ResRipper/OpenThereminV4/Electronics/OpenThereminV45_BOM.ods

Reference | Value | Footprint | Qty | LCSC | PN | Vendor | Note
C1,C2,C3,C7,C8,C9,C10 | 150p | Capacitor_SMD:C_0603_1608Metric | 7 | C107038 | CC0603JRNPO9BN151 | YAGEO | C0G/N0P
C5,C12 | 470p | Capacitor_SMD:C_0603_1608Metric | 2 | C106211 | CC0603JRNPO9BN471 | YAGEO | C0G/N0P
C6,C13,C20,C21,C23,C24,C25,C26,C27,C28,C30,C32,C33,C35 | 100n | Capacitor_SMD:C_0603_1608Metric | 14 | C282519 | TCC0603X7R104K500CT | CCTC
C11 | 10pF | Capacitor_SMD:C_0603_1608Metric | 1 | C376764 | TCC0603COG100J500CT | CCTC | C0G/N0P
C14 | 47p | Capacitor_SMD:C_0603_1608Metric | 1 | C94904 | 0603CG470J500NT | FH | C0G/N0P
C15,C16,C34 | 22p | Capacitor_SMD:C_0603_1608Metric | 3 | C105620 | CC0603JRNPO9BN220 | YAGEO | C0G/N0P
C17,C18 | 30p | Capacitor_SMD:C_0603_1608Metric | 2 | C107047 | CC0603JRNPO9BN330 | YAGEO | C0G/N0P
C22,C38 | 10n | Capacitor_SMD:C_0603_1608Metric | 2 | C376807 | TCC0603X7R103M500CT | CCTC
C29,C36,C37 | 10u | Capacitor_SMD:C_0603_1608Metric | 3 | C1691 | CL10A106MQ8NNNC | Samsung
D1,D2 | BB914 | TO_SOT_Packages_SMD:SOT-23 | 2 | C3272485 | BB914E6327HTSA1 | Infineon
D3 | LTST-C235KGKRKT | LED_SMD:LED_LiteOn_LTST-C235KGKRKT | 1 | C125110 | LTST-C235KGKRKT | LITEON
J3 | Conn_02x04_Odd_Even | Connector_PinHeader_1.27mm:PinHeader_2x04_P1.27mm_Vertical_SMD | 1 | C19268845 | XDZ127-2-04-S-1.0-G1 | XUNDA
J4,J5 | PJ-320B | Library:XKB_PJ-320B | 2 | C2884998 | PJ-320B-SMT | XKB
J6 | USB_C_Receptacle_USB2.0_16P | Connector_USB:USB_C_Receptacle_GCT_USB4105-xx-A_16P_TopMnt_Horizontal | 1 | C2988369 | GT-USB-7010AB | G-Switch
L1,L2 | 1mH | Inductor_SMD:L_1812_4532Metric | 2 | C394145 | FHW1812IF102KST | FH
P1,P2,P3,P4 | 10k | Library:ALPS_RK09K1130A6S | 4 | C209770 | RK09K1130A6S | ALPS
R1,R5,R11,R13 | 4.7M | Resistor_SMD:R_0603_1608Metric | 4 | C322165 | RS-03L4704FT | FH | 1%
R2,R6,R9,R10,R20 | 2.2k | Resistor_SMD:R_0603_1608Metric | 5 | C294652 | RS-03K2201FT | FH | 1%
R3,R4,R7,R8,R15,R16 | 100k | Resistor_SMD:R_0603_1608Metric | 6 | C3152121 | SC0603F1003F2BNRH | Sunway | 1%
R12,R14,R18,R19 | 470 | Resistor_SMD:R_0603_1608Metric | 4 | C116694 | RS-03K4700FT | FH | 1%
R17 | 10k | Resistor_SMD:R_0603_1608Metric | 1 | C3152123 | SC0603F1002F2BNRH | Sunway
R21,R22 | 5.1k | Resistor_SMD:R_0603_1608Metric | 2 | C3152148 | SC0603F5101F2BNRH | Sunway | 1%
U1 | TTP223 | Package_TO_SOT_SMD:SOT-23-6 | 1 | C5345654 | HK2301 | Hichon
U2,U3 | 74HC4060D | Package_SO:SOIC-16_3.9x9.9mm_P1.27mm | 2 | C5649 | 74HC4060D,653 | Nexperia
U4 | 74HC74 | Package_SO:SOIC-14_3.9x8.7mm_P1.27mm | 1 | C27597 | 74HC74D,653 | Nexperia
U5 | HEF4069 | Package_SO:SOIC-14_3.9x8.7mm_P1.27mm | 1 | C6739 | HEF4069UBT,653 | Nexperia
U6 | MCP4921-E/SN | Package_SO:SOIC-8_3.9x4.9mm_P1.27mm | 1 | C43499 | MCP4921-E/SN | Microchip
U7,U12 | MCP4922-E/SL | Package_SO:SOIC-14_3.9x8.7mm_P1.27mm | 2 | C39851 | MCP4922-E/SL | Microchip
U8 | MCP6002T-I/SN | Package_SO:SOIC-8_3.9x4.9mm_P1.27mm | 1 | C20538868 | MCP6002T-I/SN(MS) | MSKSEMI
U9 | ATmega328P-AU | Package_QFP:TQFP-32_7x7mm_P0.8mm | 1 | C14877 | ATmega328P-AU | Microchip
U10 | CH340C | Package_SO:SOIC-16_3.9x9.9mm_P1.27mm | 1 | C84681 | CH340C | WCH
U11 | LP2985-3.3 | Package_TO_SOT_SMD:SOT-23-5 | 1 | C95414 | LP2985-33DBVR | Ti
X1 | 16MHz | Crystal:Crystal_SMD_HC49-SD | 1 | C7473031 | M49SMD16M15PF15PPM | SST | 15~18pF
X2 | 7.3728MHz | Crystal:Crystal_SMD_HC49-SD | 1 | C19173022 | RC07372602 | TROQ | 20pF
J1,J7 | Pitch / Volume | Connector_Coaxial:SMA_Amphenol_132134-11_Vertical | 2 | C5723187 | SMA-KE-347A-H13.5-P | Xunpu
