ResRipper/OpenThereminV4/Electronics/OpenThereminV45.kicad_pcb

## KiCad design Electronics/OpenThereminV45.kicad_pcb (2024-10-14)

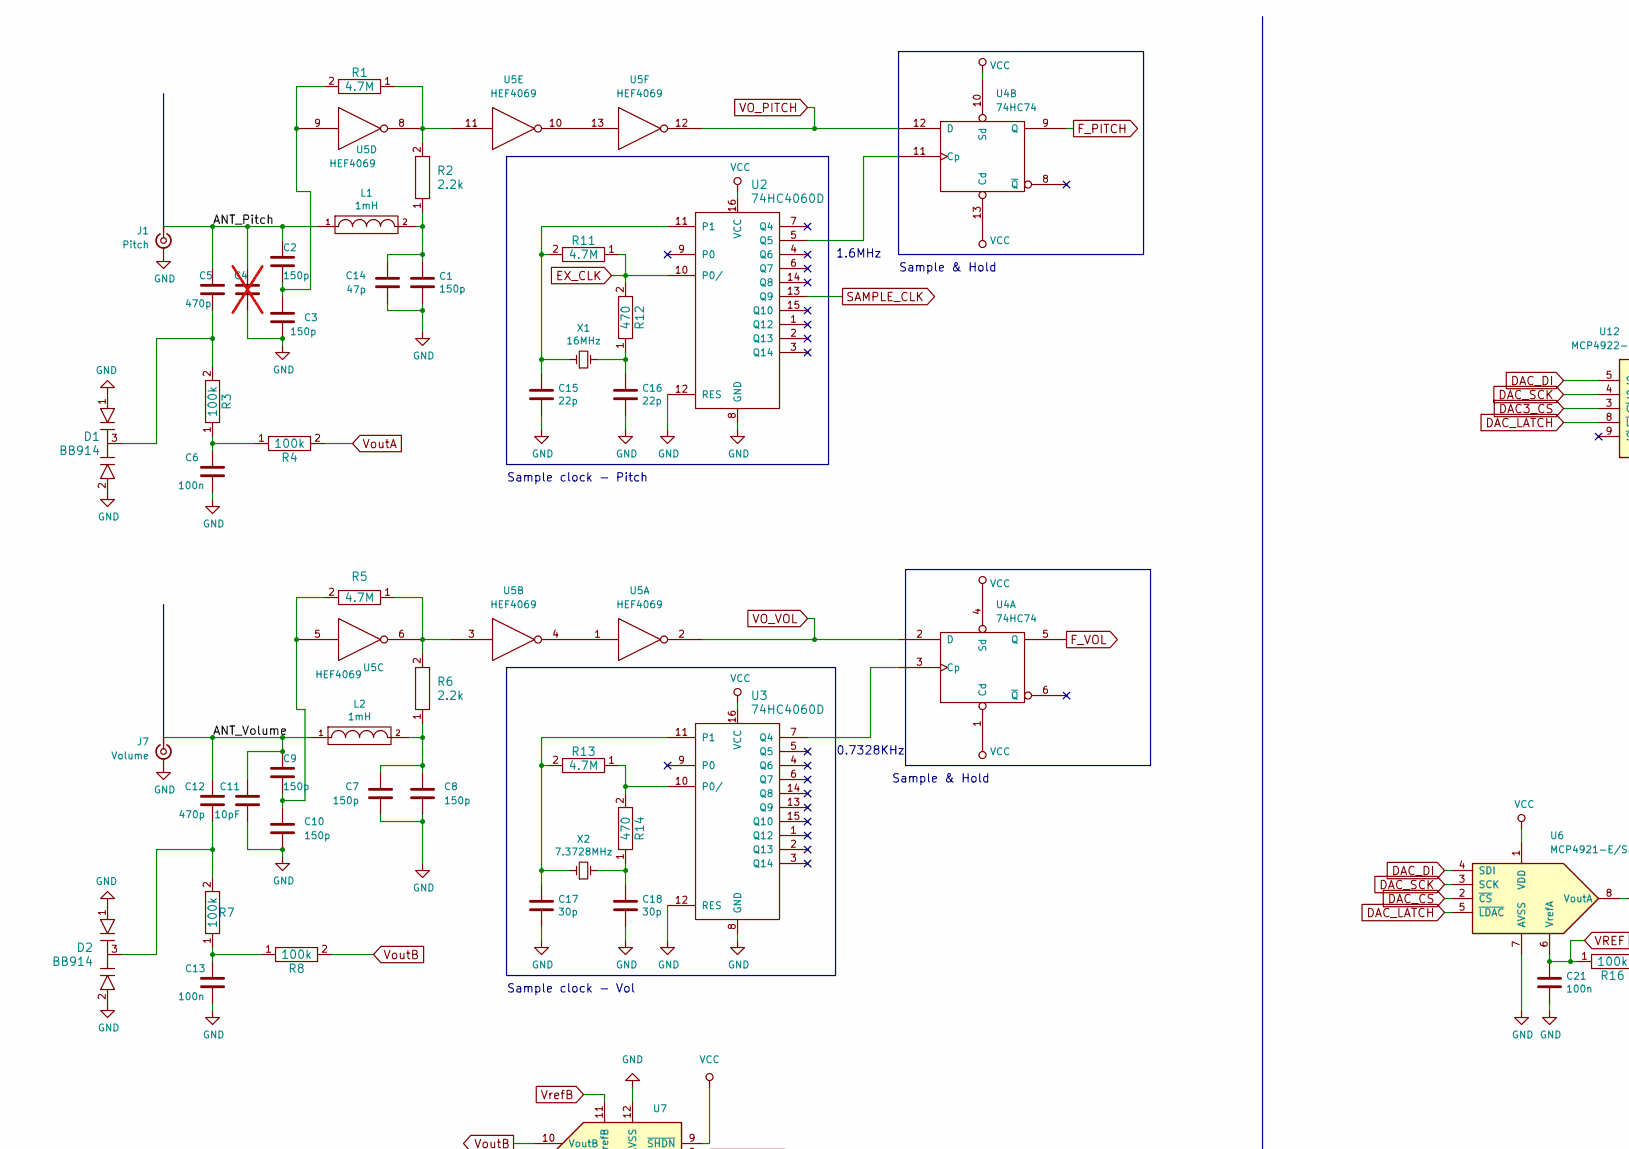
[picture p1: schematic OpenThereminV45.kicad_sch, Open.Theremin V4.5, part in row 1, column 1]

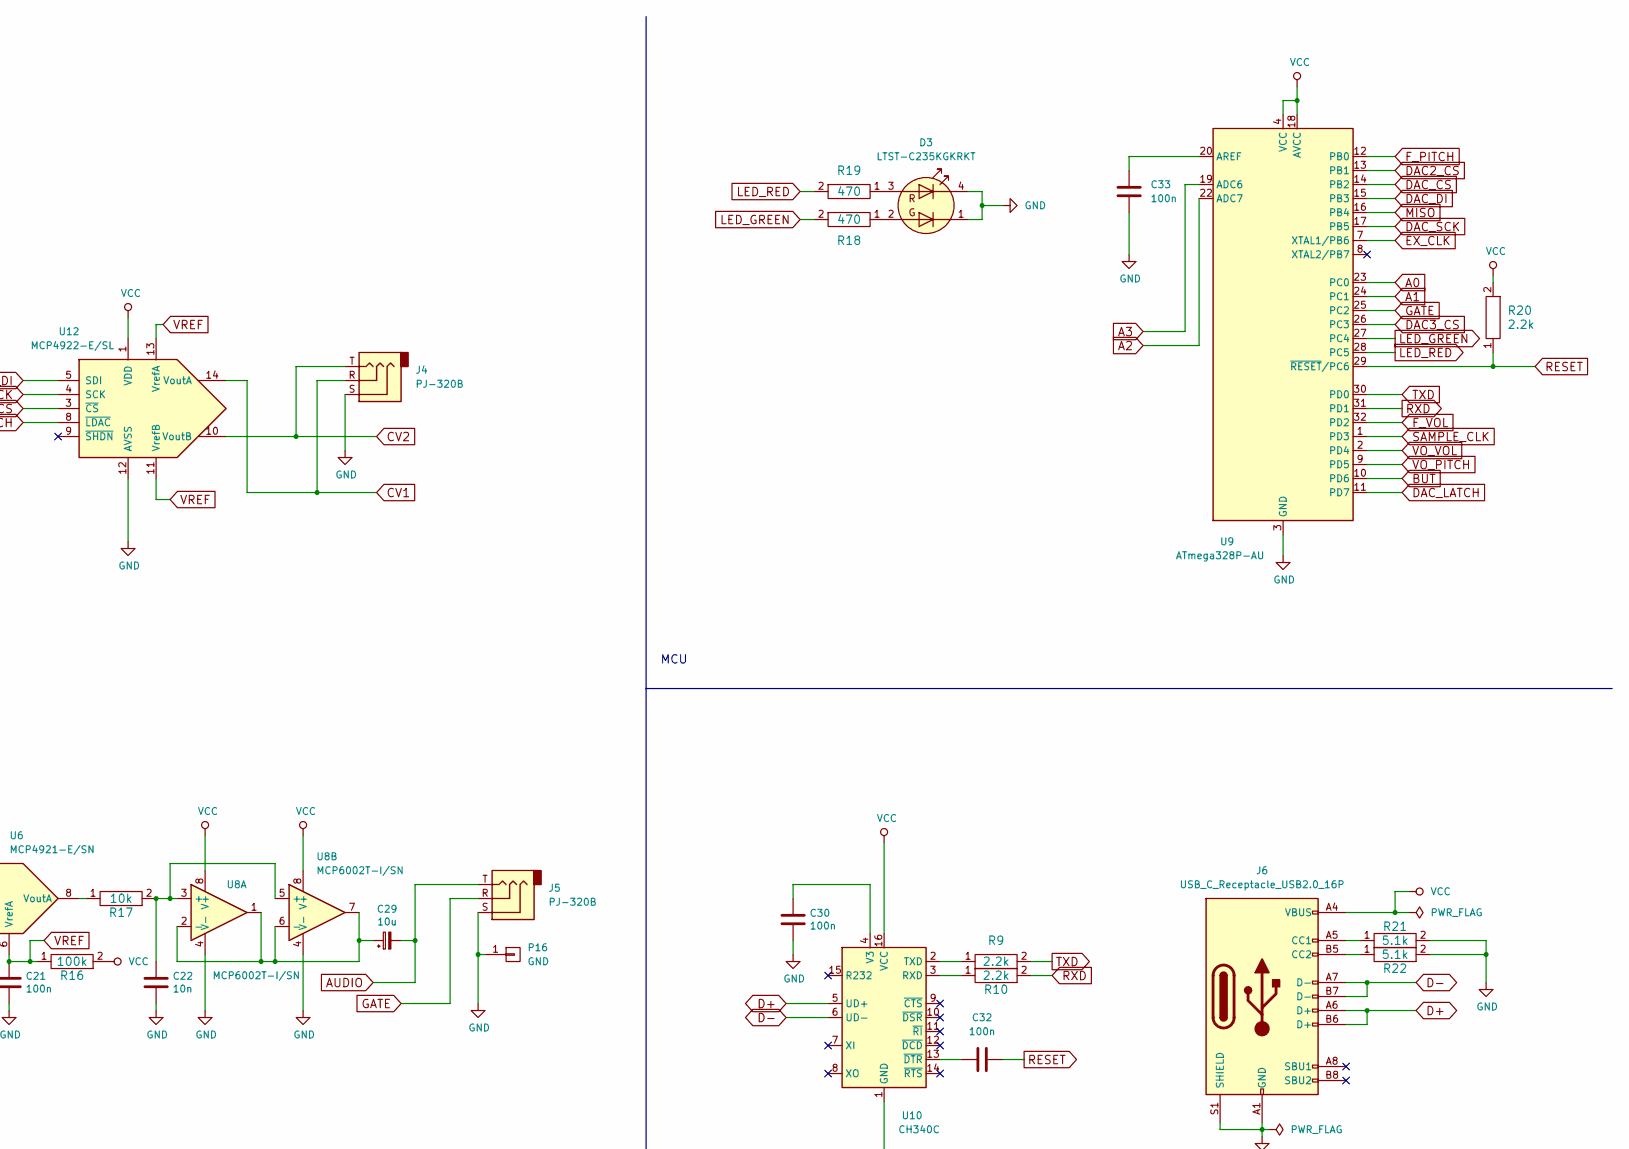
[picture p2: schematic OpenThereminV45.kicad_sch, Open.Theremin V4.5, part in row 1, column 2]

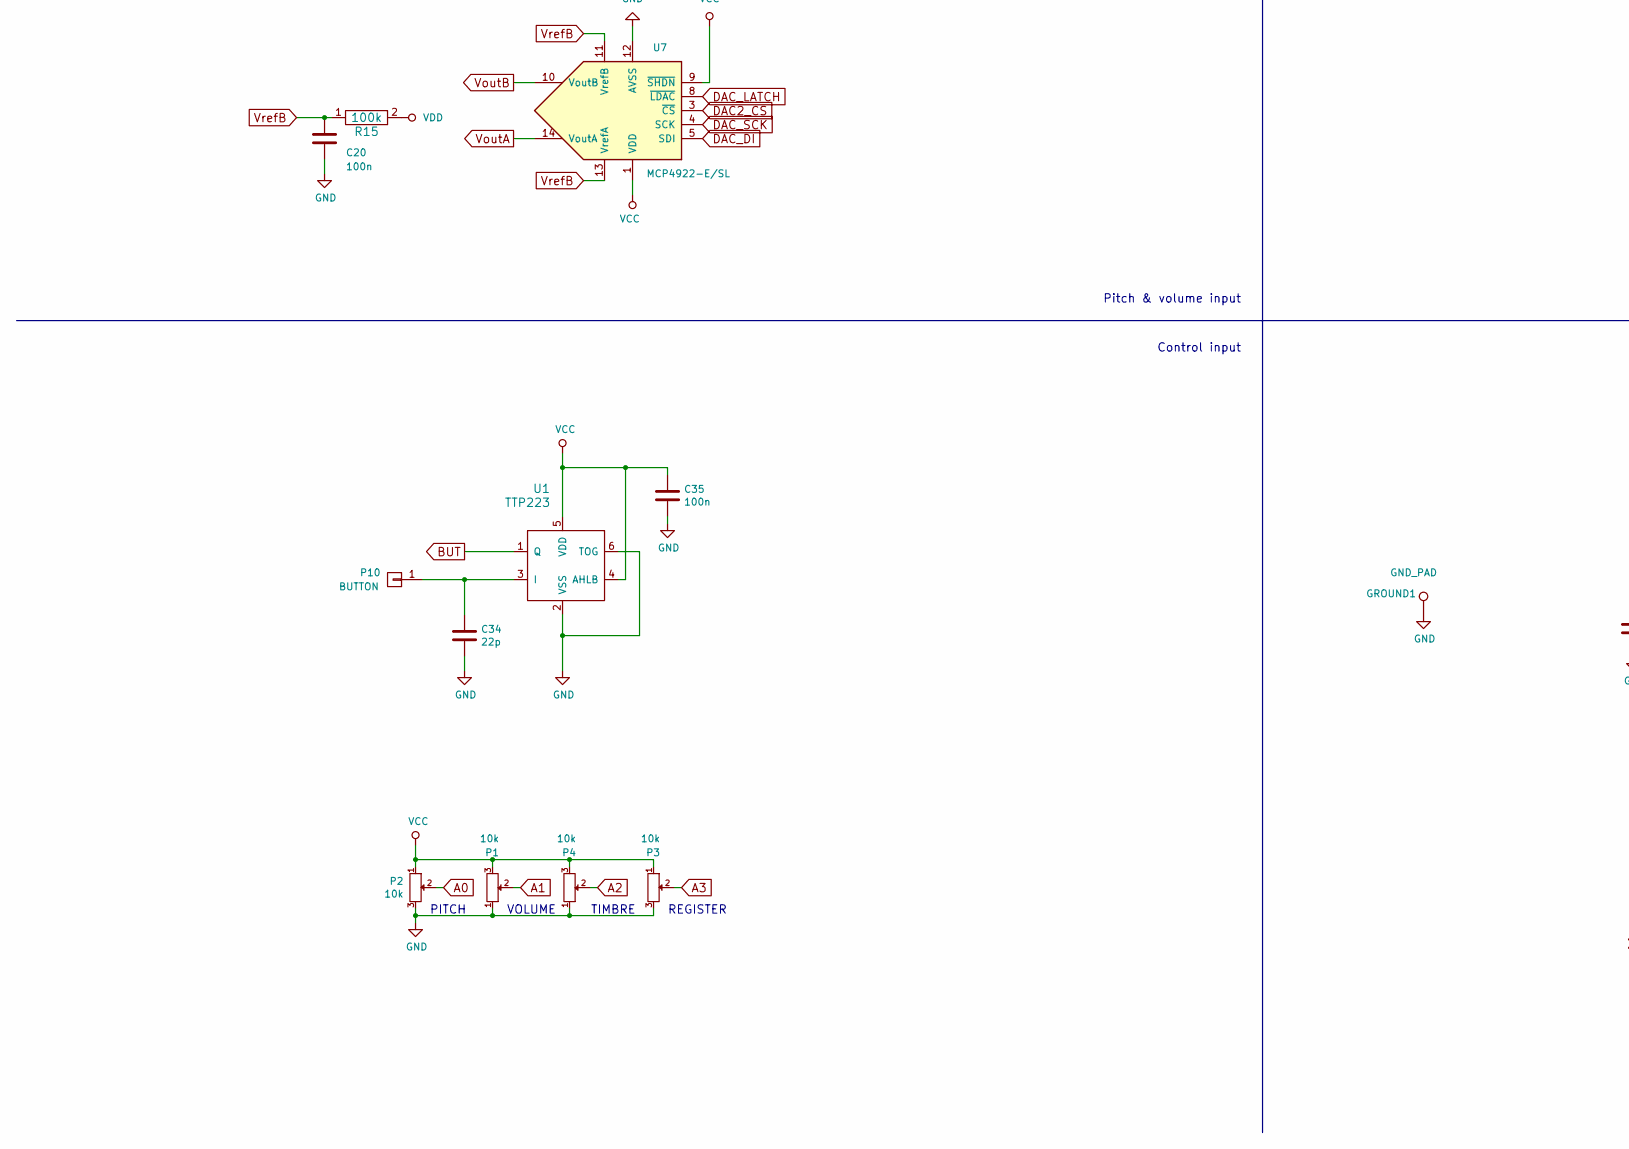
[picture p3: schematic OpenThereminV45.kicad_sch, Open.Theremin V4.5, part in row 2, column 1]

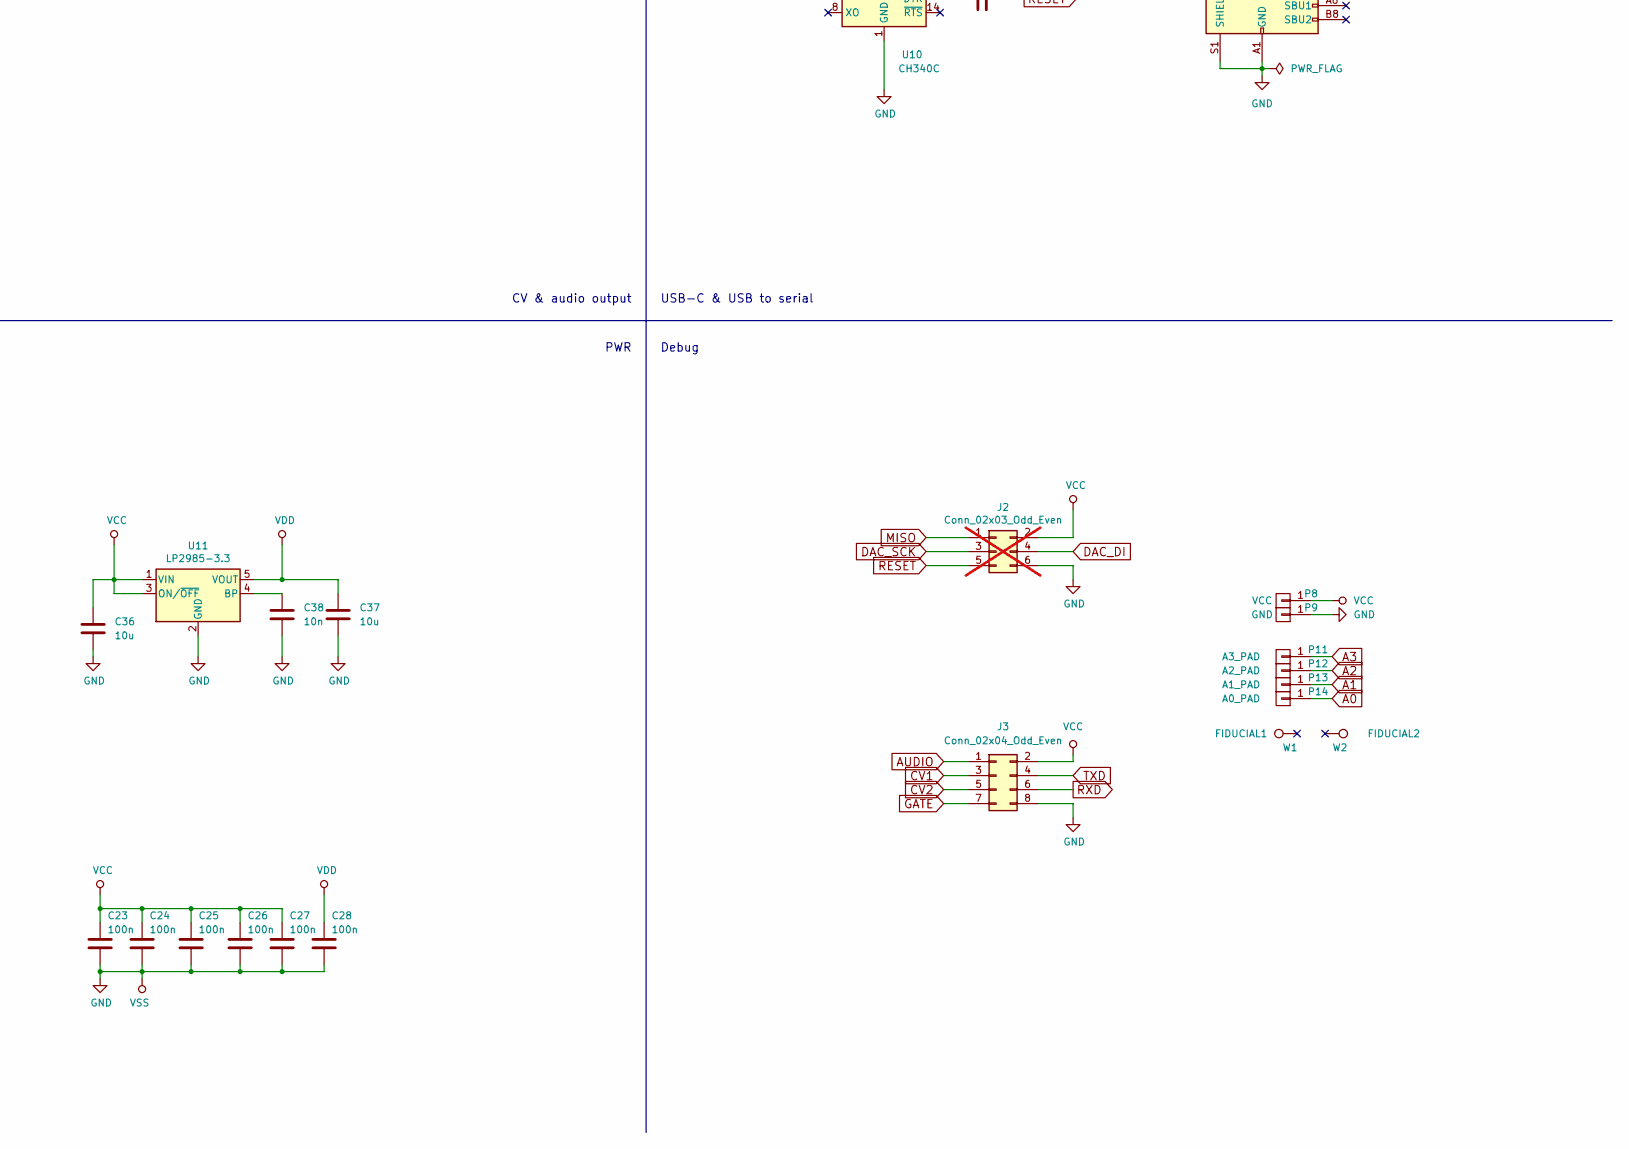
[picture p4: schematic OpenThereminV45.kicad_sch, Open.Theremin V4.5, part in row 2, column 2]

Parts:
C1, C2, C3, C7, C8, C9, C10: 150p; C_0603_1608Metric; LCSC C107038
C4: C_0603_1608Metric; not fitted
C5, C12: 470p; C_0603_1608Metric; LCSC C106211
C6, C13, C20, C21, C23, C24, C25, C26, C27, C28, C30, C32, C33, C35: 100n; C_0603_1608Metric; LCSC C282519
C11: 10pF; C_0603_1608Metric; LCSC C376764
C14: 47p; C_0603_1608Metric; LCSC C94904
C15, C16, C34: 22p; C_0603_1608Metric; LCSC C105620
C17, C18: 30p; C_0603_1608Metric; LCSC C107047
C22, C38: 10n; C_0603_1608Metric; LCSC C376807
C29, C36, C37: 10u; C_0603_1608Metric; LCSC C1691
D1, D2: BB914; SOT-23; LCSC C3272485
D3: LTST-C235KGKRKT; LED_LiteOn_LTST-C235KGKRKT; LCSC C125110
GROUND1: GND_PAD; GNDPad
J1: Pitch; SMA_Amphenol_132134-11_Vertical; LCSC C5723187
J2: Conn_02x03_Odd_Even; Tag-Connect_TC2030-IDC-NL_2x03_P1.27mm_Vertical; not fitted
J3: Conn_02x04_Odd_Even; PinHeader_2x04_P1.27mm_Vertical_SMD; LCSC C19268845
J4, J5: PJ-320B; XKB_PJ-320B; LCSC C2884998
J6: USB_C_Receptacle_USB2.0_16P; USB_C_Receptacle_GCT_USB4105-xx-A_16P_TopMnt_Horizontal; LCSC C2988369
J7: Volume; SMA_Amphenol_132134-11_Vertical; LCSC C5723187
L1, L2: 1mH; L_1812_4532Metric; LCSC C394145
P1, P2, P3, P4: 10k; ALPS_RK09K1130A6S; LCSC C209770
P8: VCC; SMD_Pinheader_1_OT_BLANK
P9, P16: GND; SMD_Pinheader_1_OT_BLANK
P10: BUTTON; SensorButton
P11: A3_PAD; SMD_Pinheader_1_OT_BLANK
P12: A2_PAD; SMD_Pinheader_1_OT_BLANK
P13: A1_PAD; SMD_Pinheader_1_OT_BLANK
P14: A0_PAD; SMD_Pinheader_1_OT_BLANK
R1, R5, R11, R13: 4.7M; R_0603_1608Metric; LCSC C322165
R2, R6, R9, R10, R20: 2.2k; R_0603_1608Metric; LCSC C294652
R3, R4, R7, R8, R15, R16: 100k; R_0603_1608Metric; LCSC C3152121
R12, R14, R18, R19: 470; R_0603_1608Metric; LCSC C116694
R17: 10k; R_0603_1608Metric; LCSC C3152123
R21, R22: 5.1k; R_0603_1608Metric; LCSC C3152148
U1: TTP223; SOT-23-6; LCSC C5345654
U2, U3: 74HC4060D; SOIC-16_3.9x9.9mm_P1.27mm; LCSC C5649
U4: 74HC74; SOIC-14_3.9x8.7mm_P1.27mm; LCSC C27597
U5: HEF4069; SOIC-14_3.9x8.7mm_P1.27mm; LCSC C6739
U6: MCP4921-E/SN; SOIC-8_3.9x4.9mm_P1.27mm; LCSC C43499
U7, U12: MCP4922-E/SL; SOIC-14_3.9x8.7mm_P1.27mm; LCSC C39851
U8: MCP6002T-I/SN; SOIC-8_3.9x4.9mm_P1.27mm; LCSC C20538868
U9: ATmega328P-AU; TQFP-32_7x7mm_P0.8mm; LCSC C14877
U10: CH340C; SOIC-16_3.9x9.9mm_P1.27mm; LCSC C84681
U11: LP2985-3.3; SOT-23-5; LCSC C95414
W1: FIDUCIAL1; Fiducial_1mm_Dia_2.54mm_Outer_CopperBottom
W2: FIDUCIAL2; Fiducial_1mm_Dia_2.54mm_Outer_CopperBottom
X1: 16MHz; Crystal_SMD_HC49-SD; LCSC C7473031
X2: 7.3728MHz; Crystal_SMD_HC49-SD; LCSC C19173022

Connections:
/ANT_Pitch: C2.1, C4.1, C5.1, J1.1 (In), L1.1
/ANT_Volume: C9.1, C11.1, C12.1, J7.1 (In), L2.1
A0: P2.2, P14.1, U9.23 (PC0)
A1: P1.2, P13.1, U9.24 (PC1)
A2: P4.2, P12.1, U9.22 (ADC7)
A3: P3.2, P11.1, U9.19 (ADC6)
AUDIO: C29.2, J3.1, J5.T
BUT: U1.1 (Q), U9.10 (PD6)
CV1: J3.3, J4.R, U12.14 (VoutA)
CV2: J3.5, J4.T, U12.10 (VoutB)
D+: J6.A6 (D+), J6.B6 (D+), U10.5 (UD+)
D-: J6.A7 (D-), J6.B7 (D-), U10.6 (UD-)
DAC2_CS: U7.3 (~CS), U9.13 (PB1)
DAC3_CS: U9.26 (PC3), U12.3 (~CS)
DAC_CS: U6.2 (~CS), U9.14 (PB2)
DAC_DI: J2.4, U6.4 (SDI), U7.5 (SDI), U9.15 (PB3), U12.5 (SDI)
DAC_LATCH: U6.5 (~LDAC), U7.8 (~LDAC), U9.11 (PD7), U12.8 (~LDAC)
DAC_SCK: J2.3, U6.3 (SCK), U7.4 (SCK), U9.17 (PB5), U12.4 (SCK)
EX_CLK: R11.1, R12.2, U2.10 (P0/), U9.7 (XTAL1/PB6)
F_PITCH: U4.9 (Q), U9.12 (PB0)
F_VOL: U4.5 (Q), U9.32 (PD2)
GATE: J3.7, J5.R, U9.25 (PC2)
GND: C1.2, C3.2, C4.2, C6.2, C7.2, C8.2, C10.2, C11.2, C13.2, C14.2, C15.2, C16.2, C17.2, C18.2, C20.2, C21.2, C22.2, C23.2, C24.2, C25.2, C26.2, C27.2, C28.2, C30.2, C33.2, C34.2, C35.2, C36.2, C37.2, C38.2, D1.1, D1.2, D2.1, D2.2, D3.1 (K2), D3.4 (K1), GROUND1.1, J1.2 (Ext), J2.6, J3.8, J4.S, J5.S, J6.A1 (GND), J6.A12 (GND), J6.B1 (GND), J6.B12 (GND), J6.S1 (SHIELD), J7.2 (Ext), P1.1, P2.3, P3.3, P4.1, P9.1, P16.1, R21.2, R22.2, U1.2 (VSS), U1.6 (TOG), U2.8 (GND), U2.12 (RES), U3.8 (GND), U3.12 (RES), U4.7 (GND), U5.7 (VSS), U6.7 (AVSS), U7.12 (AVSS), U8.4 (V-), U9.3 (GND), U9.5 (GND), U9.21 (GND), U10.1 (GND), U11.2 (GND), U12.12 (AVSS)
LED_GREEN: R18.2, U9.27 (PC4)
LED_RED: R19.2, U9.28 (PC5)
MISO: J2.1, U9.16 (PB4)
unnamed: C1.1, C14.1, L1.2, R2.1
unnamed: C2.2, C3.1, R1.2, U5.9
unnamed: C5.2, D1.3, R3.2
unnamed: C6.1, R3.1, R4.1
unnamed: C7.1, C8.1, L2.2, R6.1
unnamed: C9.2, C10.1, R5.2, U5.5
unnamed: C12.2, D2.3, R7.2
unnamed: C13.1, R7.1, R8.1
unnamed: C16.1, R12.1, X1.2
unnamed: C18.1, R14.1, X2.2
unnamed: D3.3 (A1), R19.1
unnamed: D3.2 (A2), R18.1
unnamed: J6.A5 (CC1), R21.1
unnamed: J6.B5 (CC2), R22.1
unnamed: C34.1, P10.1, U1.3 (I)
unnamed: R1.1, R2.2, U5.8, U5.11
unnamed: R5.1, R6.2, U5.3, U5.6
unnamed: C15.1, R11.2, U2.11 (P1), X1.1
unnamed: U2.5 (Q5), U4.11 (Cp)
unnamed: R13.1, R14.2, U3.10 (P0/)
unnamed: C17.1, R13.2, U3.11 (P1), X2.1
unnamed: U3.7 (Q4), U4.3 (Cp)
unnamed: U5.1, U5.4
unnamed: U5.10, U5.13
unnamed: R17.1, U6.8 (VoutA)
unnamed: C22.1, R17.2, U8.3 (+), U8.5 (+)
unnamed: C29.1, U8.1, U8.2 (-), U8.6 (-), U8.7
unnamed: C33.1, U9.20 (AREF)
unnamed: R10.1, U10.3 (RXD)
unnamed: R9.1, U10.2 (TXD)
unnamed: C30.1, U10.4 (V3)
unnamed: C32.2, U10.13 (~DTR)
unnamed: C38.1, U11.4 (BP)
RESET: C32.1, J2.5, R20.1, U9.29 (~RESET/PC6)
RXD: J3.6, R10.2, U9.31 (PD1)
SAMPLE_CLK: U2.13 (Q9), U9.1 (PD3)
TXD: J3.4, R9.2, U9.30 (PD0)
VCC: C23.1, C24.1, C25.1, C26.1, C27.1, C35.1, C36.1, J2.2, J3.2, J6.A4 (VBUS), J6.A9 (VBUS), J6.B4 (VBUS), J6.B9 (VBUS), P1.3, P2.1, P3.1, P4.3, P8.1, R16.2, R20.2, U1.4 (AHLB), U1.5 (VDD), U2.16 (VCC), U3.16 (VCC), U4.1 (Cd), U4.4 (Sd), U4.10 (Sd), U4.13 (Cd), U4.14 (VCC), U6.1 (VDD), U7.1 (VDD), U7.9 (~SHDN), U8.8 (V+), U9.4 (VCC), U9.6 (VCC), U9.18 (AVCC), U10.16 (VCC), U11.1 (VIN), U11.3 (ON/~OFF), U12.1 (VDD)
VDD: C28.1, C37.1, R15.2, U5.14 (VDD), U11.5 (VOUT)
VO_PITCH: U4.12 (D), U5.12, U9.9 (PD5)
VO_VOL: U4.2 (D), U5.2, U9.2 (PD4)
VREF: C21.1, R16.1, U6.6 (VrefA), U12.11 (VrefB), U12.13 (VrefA)
VoutA: R4.2, U7.14 (VoutA)
VoutB: R8.2, U7.10 (VoutB)
VrefB: C20.1, R15.1, U7.11 (VrefB), U7.13 (VrefA)

Notes on the sheet:
Sample clock - Pitch
PWR
Sample & Hold
REGISTER
MCU
0.7328KHz
VOLUME
Pitch & volume input
TIMBRE
PITCH
Debug
USB-C & USB to serial
Sample clock - Vol
1.6MHz
CV & audio output
Control input

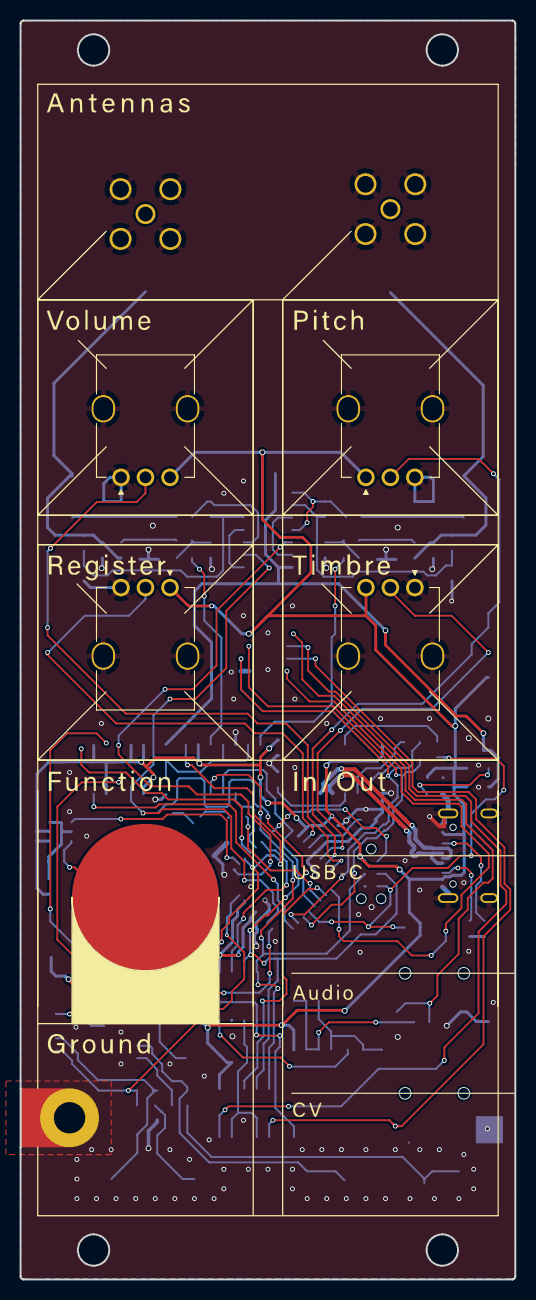
[picture p5: board OpenThereminV45.kicad_pcb from above]

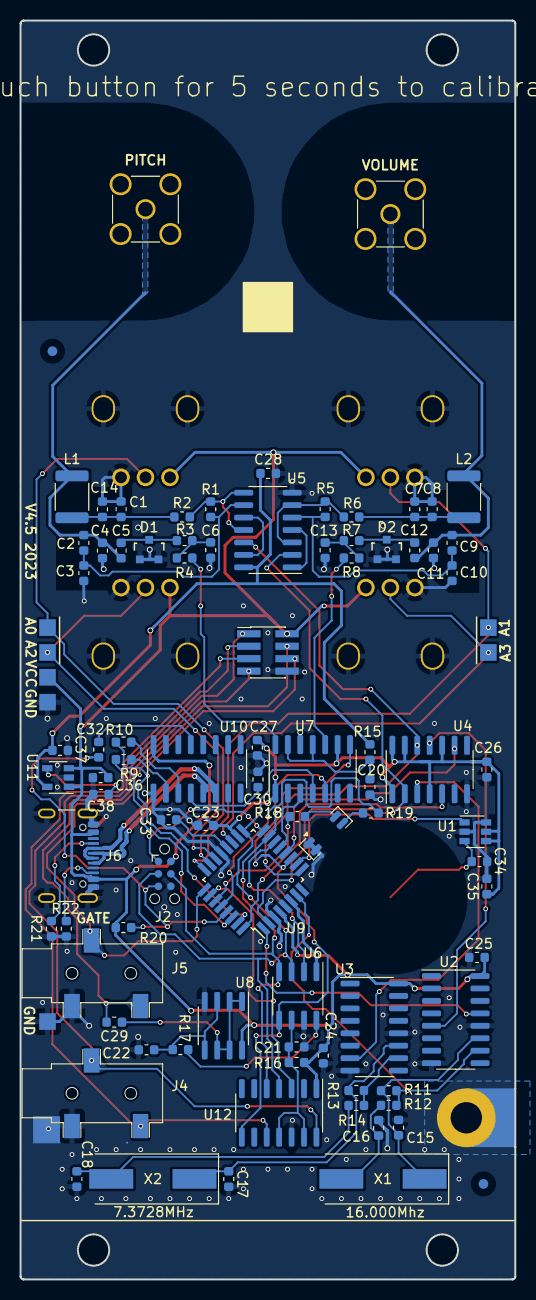
[picture p6: board OpenThereminV45.kicad_pcb from below]

Board: 2 copper layers, 50.5 x 128.5 mm, 99 parts (93 on the bottom side), 71 nets.
