ResRipper/OpenThereminV4/(commit log)

2024-09-24 Update schema
    - Re-organize schema layout
    - Move DNP info from text description to part attribute
    - Move PN info from text description to part attribute
    - Fix I/O attribute for some pins and labels
    - Add NC labels for unused pins
    - Added LCSC, Vendor and PN info for most parts
    [OpenThereminV45.kicad_sch]
2024-09-25 Remove outdated files
    [OpenThereminV45.sch, OpenThereminV4_5_BOM.ods]
2024-09-25 Update schema & layout
    - Adjust layout base on JLC capabilities
    - Re-do USB layout
    - Replace 3.5mm jack, inductor, type-c connector and LED with higher availability option
    - Add 5x5mm SN block
    - Remove some logos and text for personal preference
    [OpenThereminV45.kicad_pcb, OpenThereminV45.kicad_sch]
2024-09-25 Generate gerber files
2024-09-25 Remove tag-connect from BOM
    [OpenThereminV45.kicad_sch]
2024-09-25 Replace 02x05 pin connector with 02x04
    [OpenThereminV45.kicad_pcb, OpenThereminV45.kicad_sch]
2024-09-25 Set component info for ANT connector
    [OpenThereminV45.kicad_sch]
2024-10-01 Update schema & layout
    - Use SMA as antenna connector
    - Replace potentiometers with cheaper & higher avaliability option
    - Re-route some of the traces
    [OpenThereminV45.kicad_pcb, OpenThereminV45.kicad_sch]
2024-10-01 Add BOM file
    [OpenThereminV45_BOM.ods]
2024-10-01 Remove unneeded files
    [OpenThereminCC-2019-06-01-18-08-36.sch, OpenThereminCC-2019-06-01-19-16-51.sch, OpenThereminCC-2019-06-01-20-19-36.sch, OpenThereminCC-2019-06-01-20-23-04.sch, OpenThereminCC-2019-12-06-09-29-51.sch, OpenThereminV4-2021-03-16-08-46-09.sch]
2024-10-10 Minor changes to the layout
    [OpenThereminV45.kicad_pcb]
2024-10-14 Correct 2x4 pin header part info
    [OpenThereminV45.kicad_pcb, OpenThereminV45.kicad_sch, OpenThereminV45_BOM.ods]
